sat-wik/HardFuzz/hardware/hardfuzz_v1/gen/_pcb_setup.txt

	(setup
		(stackup
			(layer "F.SilkS"
				(type "Top Silk Screen")
			)
			(layer "F.Paste"
				(type "Top Solder Paste")
			)
			(layer "F.Mask"
				(type "Top Solder Mask")
				(color "Green")
				(thickness 0.01)
			)
			(layer "F.Cu"
				(type "copper")
				(thickness 0.035)
			)
			(layer "dielectric 1"
				(type "core")
				(thickness 1.51)
				(material "FR4")
				(epsilon_r 4.5)
				(loss_tangent 0.02)
			)
			(layer "B.Cu"
				(type "copper")
				(thickness 0.035)
			)
			(layer "B.Mask"
				(type "Bottom Solder Mask")
				(color "Green")
				(thickness 0.01)
			)
			(layer "B.Paste"
				(type "Bottom Solder Paste")
			)
			(layer "B.SilkS"
				(type "Bottom Silk Screen")
			)
			(copper_finish "None")
			(dielectric_constraints no)
		)
		(pad_to_mask_clearance 0)
		(allow_soldermask_bridges_in_footprints no)
		(tenting front back)
		(aux_axis_origin 33.02 118.745)
		(grid_origin 33.02 118.745)
		(pcbplotparams
			(layerselection 0x00000000_00000000_00000000_000000a5)
			(plot_on_all_layers_selection 0x00000000_00000000_00000000_00000000)
			(disableapertmacros no)
			(usegerberextensions yes)
			(usegerberattributes no)
			(usegerberadvancedattributes no)
			(creategerberjobfile no)
			(dashed_line_dash_ratio 12.000000)
			(dashed_line_gap_ratio 3.000000)
			(svgprecision 6)
			(plotframeref no)
			(mode 1)
			(useauxorigin no)
			(hpglpennumber 1)
			(hpglpenspeed 20)
			(hpglpendiameter 15.000000)
			(pdf_front_fp_property_popups yes)
			(pdf_back_fp_property_popups yes)
			(pdf_metadata yes)
			(pdf_single_document no)
			(dxfpolygonmode yes)
			(dxfimperialunits yes)
			(dxfusepcbnewfont yes)
			(psnegative no)
			(psa4output no)
			(plot_black_and_white yes)
			(plotinvisibletext no)
			(sketchpadsonfab no)
			(plotpadnumbers no)
			(hidednponfab no)
			(sketchdnponfab yes)
			(crossoutdnponfab yes)
			(subtractmaskfromsilk no)
			(outputformat 1)
			(mirror no)
			(drillshape 1)
			(scaleselection 1)
			(outputdirectory "")
		)
	)
