sat-wik/HardFuzz/hardware/hardfuzz_v1/gen/kigen.py

#!/usr/bin/env python3
"""kigen — a tiny KiCad 10 schematic generator for the HardFuzz v1 board.

The board is defined as code (see sheets/*.py); this emits a valid `.kicad_sch`
(format 20250114) that opens in eeschema and passes ERC. Approach:

  * pull each library symbol's *raw text* from KiCad's stock .kicad_sym files so
    quoting/formatting is authoritative (no re-serialization guesswork),
  * place every component at rotation 0 so the pin transform is just Y-flip
    (sheet_pin = origin + (px, -py)),
  * connect pins with local net *labels* dropped exactly on each pin endpoint —
    same label name == same net, no fragile wire routing.

The result is an electrically-correct, ERC-checkable "netlist as schematic".
Aesthetic routing is left to eeschema; correctness is what we generate.
"""
import os, re, sys, uuid, math

SYMDIR = "/Applications/KiCad/KiCad.app/Contents/SharedSupport/symbols"
SKILL = "/Users/satwikpattanaik/.claude/plugins/marketplaces/kicad-happy/skills/kicad/scripts"
sys.path.insert(0, SKILL)
import sexp_parser as S


def _match_block(text, start):
    """Given index of '(' at `start`, return end index just past matching ')'."""
    depth = 0
    i = start
    in_str = False
    while i < len(text):
        c = text[i]
        if in_str:
            if c == '"' and text[i-1] != '\\':
                in_str = False
        elif c == '"':
            in_str = True
        elif c == '(':
            depth += 1
        elif c == ')':
            depth -= 1
            if depth == 0:
                return i + 1
        i += 1
    raise ValueError("unbalanced")


class LibCache:
    def __init__(self):
        self._files = {}   # libname -> text
        self._raw = {}     # lib_id -> renamed raw symbol block
        self._pins = {}    # lib_id -> [(number,x,y,angle)]

    def _load(self, libname):
        if libname not in self._files:
            with open(os.path.join(SYMDIR, libname + ".kicad_sym")) as f:
                self._files[libname] = f.read()
        return self._files[libname]

    def _find_symbol_span(self, text, name):
        pat = re.compile(r'\(symbol\s+"' + re.escape(name) + r'"')
        m = pat.search(text)
        if not m:
            raise KeyError(name)
        end = _match_block(text, m.start())
        return m.start(), end

    def _base_block(self, lib_id):
        """(raw text, base symbol name) of the ancestor that actually carries pins,
        following `extends` down the chain."""
        libname, name = lib_id.split(":")
        text = self._load(libname)
        s, e = self._find_symbol_span(text, name)
        block = text[s:e]
        m = re.search(r'\(extends\s+"([^"]+)"', block)
        if m:
            return self._base_block(f"{libname}:{m.group(1)}")
        return block, name

    def raw(self, lib_id):
        """Self-contained '(symbol "lib:name" ...)' block for lib_symbols embedding.
        Derived symbols are flattened onto the ancestor's drawing, and BOTH the top
        symbol and its child units are renamed so the child base matches the top's
        un-prefixed name (KiCad requires "<TopBase>_<unit>_<style>")."""
        if lib_id in self._raw:
            return self._raw[lib_id]
        block, base = self._base_block(lib_id)
        top_base = lib_id.split(":")[1]
        # child units: "<base>_u_s" -> "<top_base>_u_s"
        block = re.sub(r'(\(symbol\s+")' + re.escape(base) + r'(_)',
                       lambda mm: mm.group(1) + top_base + mm.group(2), block)
        # top-level: "<base>" -> "lib:name"
        block = re.sub(r'(\(symbol\s+")' + re.escape(base) + r'(")',
                       lambda mm: mm.group(1) + lib_id + mm.group(2), block, count=1)
        self._raw[lib_id] = block
        return block

    def _sym_node(self, libname, name):
        doc = S.parse_file(os.path.join(SYMDIR, libname + ".kicad_sym"))
        root = doc[0] if doc and isinstance(doc[0], list) else doc
        for n in root:
            if isinstance(n, list) and n and n[0] == "symbol" and len(n) > 1 and n[1] == name:
                return n
        raise KeyError(name)

    def extends(self, lib_id):
        """Parent lib_id if this symbol derives from another (via (extends ...)), else None.
        Reads the ORIGINAL library block — raw() flattens the extends token away."""
        libname, name = lib_id.split(":")
        text = self._load(libname)
        s, e = self._find_symbol_span(text, name)
        m = re.search(r'\(extends\s+"([^"]+)"', text[s:e])
        return f"{libname}:{m.group(1)}" if m else None

    def pins_by_unit(self, lib_id):
        """{unit_number: [(num,x,y,angle), ...]}. Child symbols are named
        '<base>_<unit>_<style>'; unit 0 holds common pins shared by every unit."""
        if lib_id in self._pins:
            return self._pins[lib_id]
        libname, name = lib_id.split(":")
        sym = self._sym_node(libname, name)
        per, total = {}, 0
        for u in sym:
            if isinstance(u, list) and u and u[0] == "symbol":
                m = re.match(re.escape(name) + r'_(\d+)_(\d+)$', u[1] if len(u) > 1 else "")
                unit = int(m.group(1)) if m else 1
                for k in u:
                    if isinstance(k, list) and k and k[0] == "pin":
                        at = S.find_first(k, "at"); num = S.find_first(k, "number")
                        if at and num:
                            per.setdefault(unit, []).append(
                                (num[1], float(at[1]), float(at[2]), float(at[3])))
                            total += 1
        if total == 0:                    # derived symbol: pins live on the parent
            parent = self.extends(lib_id)
            if parent:
                per = self.pins_by_unit(parent)
        self._pins[lib_id] = per
        return per

    def unit_count(self, lib_id):
        return max((u for u in self.pins_by_unit(lib_id) if u > 0), default=1)

    def pins(self, lib_id, unit=1):
        """Pins for a given unit, including any common (unit-0) pins."""
        pb = self.pins_by_unit(lib_id)
        return pb.get(0, []) + pb.get(unit, [])


def uid():
    return str(uuid.uuid4())


class Comp:
    def __init__(self, lib_id, ref, value, x, y, nets, footprint="", rot=0, unit=1,
                 stub=True, nc_unused=False, mpn=""):
        self.lib_id, self.ref, self.value = lib_id, ref, value
        self.x, self.y, self.rot = float(x), float(y), rot
        self.nets = nets            # {pin_number: net_name}
        self.footprint = footprint
        self.unit = unit
        self.stub = stub
        self.nc_unused = nc_unused  # place no-connect flags on pins with no net
        self.mpn = mpn
        self.uuid = uid()

    def pin_xy(self, px, py):
        # rotation 0 only: schematic Y is inverted vs symbol library
        return self.x + px, self.y - py


class Schematic:
    def __init__(self, title="HardFuzz v1", paper="A2"):
        self.lib = LibCache()
        self.comps = []
        self.title = title
        self.paper = paper
        self.uuid = uid()
        self.ox = 0.0          # block origin offset — set per block during assembly
        self.oy = 0.0
        # hierarchical assembly: when root_uuid is set this schematic is a sub-sheet
        self.root_uuid = None
        self.sheet_uuid = None     # uuid of the (sheet) symbol in the root that hosts us
        self.page = "1"
        self.global_nets = set()   # nets emitted as global_label (cross-sheet)

    @property
    def _sid(self):
        return self.sheet_uuid or self.uuid

    @property
    def _inst_path(self):
        return f"/{self.root_uuid}/{self._sid}" if self.root_uuid else f"/{self._sid}"

    @property
    def _sheet_path(self):
        return f"/{self._sid}" if self.root_uuid else "/"

    def origin(self, ox, oy):
        """Set the offset added to every subsequently-added component's position,
        so a block authored in local coords lands in its own board region."""
        self.ox, self.oy = float(ox), float(oy)

    GRID = 1.27

    def add(self, *a, **k):
        c = Comp(*a, **k)
        # snap the component origin to the 1.27 mm grid; pin offsets are already on
        # grid, so pin points / stub ends / labels derived from it stay on grid too
        c.x = round((c.x + self.ox) / self.GRID) * self.GRID
        c.y = round((c.y + self.oy) / self.GRID) * self.GRID
        self.comps.append(c)
        return c

    def _sym_instance(self, c):
        lines = []
        L = lines.append
        L(f'\t(symbol')
        L(f'\t\t(lib_id "{c.lib_id}")')
        L(f'\t\t(at {c.x:.2f} {c.y:.2f} {c.rot})')
        L(f'\t\t(unit {c.unit})')
        L(f'\t\t(exclude_from_sim no)')
        L(f'\t\t(in_bom yes)')
        L(f'\t\t(on_board yes)')
        L(f'\t\t(dnp no)')
        L(f'\t\t(uuid "{c.uuid}")')
        L(f'\t\t(property "Reference" "{c.ref}" (at {c.x+2.54:.2f} {c.y-1.27:.2f} 0)')
        L(f'\t\t\t(effects (font (size 1.27 1.27)) (justify left)))')
        L(f'\t\t(property "Value" "{c.value}" (at {c.x+2.54:.2f} {c.y+1.27:.2f} 0)')
        L(f'\t\t\t(effects (font (size 1.27 1.27)) (justify left)))')
        fp = c.footprint
        L(f'\t\t(property "Footprint" "{fp}" (at {c.x:.2f} {c.y:.2f} 0)')
        L(f'\t\t\t(effects (font (size 1.27 1.27)) (hide yes)))')
        if c.mpn:
            L(f'\t\t(property "MPN" "{c.mpn}" (at {c.x:.2f} {c.y:.2f} 0)')
            L(f'\t\t\t(effects (font (size 1.27 1.27)) (hide yes)))')
        # pin uuids
        for (num, px, py, ang) in self.lib.pins(c.lib_id, c.unit):
            L(f'\t\t(pin "{num}" (uuid "{uid()}"))')
        L(f'\t\t(instances')
        L(f'\t\t\t(project "hardfuzz_v1"')
        L(f'\t\t\t\t(path "{self._inst_path}" (reference "{c.ref}") (unit {c.unit}))))')
        L(f'\t)')
        return "\n".join(lines)

    STUB_MAX_PINS = 24    # above this, label on the pin directly — stubs on dense ICs
    #                       would cross neighbouring pins and short them together

    def _labels(self, c, stub=2.54):
        """For each connected pin: the net label at (or just off) the pin endpoint.
        Sparse parts get a short outward wire stub so labels sit clear of the body;
        dense ICs get the label right on the pin to avoid stub-crossing shorts. Text
        is justified so it always extends AWAY from the component body, never over it."""
        out = []
        pins = self.lib.pins(c.lib_id, c.unit)
        use_stub = c.stub and len(pins) <= self.STUB_MAX_PINS
        for (num, px, py, ang) in pins:
            net = c.nets.get(num)
            if not net:
                continue
            x, y = c.pin_xy(px, py)                 # pin connection point (sheet coords)
            a = math.radians((ang + 180) % 360)     # outward direction (pin `ang` -> body)
            dx, dy = math.cos(a), -math.sin(a)      # sheet space (Y flipped)
            if use_stub:
                ex, ey = round(x + dx * stub, 2), round(y + dy * stub, 2)
                out.append(
                    f'\t(wire (pts (xy {x:.2f} {y:.2f}) (xy {ex:.2f} {ey:.2f}))\n'
                    f'\t\t(stroke (width 0) (type default)) (uuid "{uid()}"))')
            else:
                ex, ey = x, y
            # rotate the label to run along the pin and justify text outward from the body
            if abs(dx) >= abs(dy):
                lang = 0
                just = "right" if dx < 0 else "left"
            else:
                lang = 90
                just = "right" if dy > 0 else "left"
            eff = f'(effects (font (size 1.27 1.27)) (justify {just}))'
            if net in self.global_nets:
                out.append(f'\t(global_label "{net}" (shape bidirectional) '
                           f'(at {ex:.2f} {ey:.2f} {lang})\n\t\t{eff}\n\t\t(uuid "{uid()}"))')
            else:
                out.append(f'\t(label "{net}" (at {ex:.2f} {ey:.2f} {lang})\n'
                           f'\t\t{eff}\n\t\t(uuid "{uid()}"))')
        return "\n".join(out)

    def _no_connects(self, c):
        """No-connect flags on this unit's pins that carry no net (intentional spares)."""
        out = []
        for (num, px, py, ang) in self.lib.pins(c.lib_id, c.unit):
            if c.nets.get(num):
                continue
            x, y = c.pin_xy(px, py)
            out.append(f'\t(no_connect (at {x:.2f} {y:.2f}) (uuid "{uid()}"))')
        return "\n".join(out)

    def render(self):
        used = {}                               # raw() flattens extends, so each
        for c in self.comps:                    # lib_id embeds as a self-contained symbol
            if c.lib_id not in used:
                used[c.lib_id] = self.lib.raw(c.lib_id)
        parts = []
        parts.append('(kicad_sch')
        parts.append('\t(version 20260306)')
        parts.append('\t(generator "hardfuzz-kigen")')
        parts.append('\t(generator_version "9.0")')
        parts.append(f'\t(uuid "{self.uuid}")')
        parts.append(f'\t(paper "{self.paper}")')
        parts.append('\t(title_block')
        parts.append(f'\t\t(title "{self.title}")')
        parts.append('\t)')
        parts.append('\t(lib_symbols')
        for lid, raw in used.items():
            # indent raw block by one tab
            parts.append("\n".join("\t" + ln for ln in raw.splitlines()))
        parts.append('\t)')
        for c in self.comps:
            parts.append(self._sym_instance(c))
            lbl = self._labels(c)
            if lbl:
                parts.append(lbl)
            if c.nc_unused:
                nc = self._no_connects(c)
                if nc:
                    parts.append(nc)
        parts.append(f'\t(sheet_instances\n\t\t(path "{self._sheet_path}" (page "{self.page}")))')
        parts.append('\t(embedded_fonts no)')
        parts.append(')')
        return "\n".join(parts) + "\n"

    PAPERS = [("A4", 297, 210), ("A3", 420, 297), ("A2", 594, 420),
              ("A1", 841, 594), ("A0", 1189, 841)]

    def _content_pts(self):
        """Every drawn point that must stay inside the frame: pin ends, stub-label
        anchors + their text extent, and component origins (Reference/Value text)."""
        pts = []
        for c in self.comps:
            pts.append((c.x + 3, c.y - 3))          # Reference/Value text sits above-right
            pins = self.lib.pins(c.lib_id, c.unit)
            use_stub = c.stub and len(pins) <= self.STUB_MAX_PINS
            for (num, px, py, ang) in pins:
                x, y = c.pin_xy(px, py)
                pts.append((x, y))
                net = c.nets.get(num)
                if not net:
                    continue
                if use_stub:
                    a = math.radians((ang + 180) % 360)
                    x, y = x + math.cos(a) * 2.54, y - math.sin(a) * 2.54
                gl = net in self.global_nets
                tw = len(net) * 0.95 + (7 if gl else 3)   # label text / flag reach
                pts.append((x + tw, y))                   # reserve room both sides — text
                pts.append((x - tw, y))                   # justifies away from the body
        return pts

    def autofit(self, margin=25, title_allow=35):
        """Translate content inside a margin and pick the smallest standard paper that
        contains all of it (pins + labels + text), so nothing spills past the frame."""
        pts = self._content_pts()
        if not pts:
            return
        minx = min(p[0] for p in pts); maxx = max(p[0] for p in pts)
        miny = min(p[1] for p in pts); maxy = max(p[1] for p in pts)
        dx, dy = margin - minx, margin - miny
        for c in self.comps:
            c.x += dx; c.y += dy
        w = (maxx - minx) + 2 * margin
        h = (maxy - miny) + 2 * margin + title_allow
        for name, pw, ph in self.PAPERS:
            if w <= pw and h <= ph:
                self.paper = name
                return
        self.paper = "A0"

    def check(self):
        """Detect accidental shorts: two different nets whose pins/stub-wires land on
        the same grid point. Stub segments are sampled at 1.27 mm so overlapping
        collinear stubs are caught. Returns [((x,y), {nets}), ...]."""
        occ = {}
        def mark(pt, net):
            occ.setdefault(pt, set()).add(net)
        for c in self.comps:
            pins = self.lib.pins(c.lib_id, c.unit)
            use_stub = c.stub and len(pins) <= self.STUB_MAX_PINS
            for (num, px, py, ang) in pins:
                net = c.nets.get(num)
                if not net:
                    continue
                x, y = c.pin_xy(px, py)
                mark((round(x, 2), round(y, 2)), net)
                if use_stub:
                    out_ang = math.radians((ang + 180) % 360)
                    dx, dy = math.cos(out_ang), -math.sin(out_ang)
                    steps = int(round(2.54 / 1.27))
                    for i in range(1, steps + 1):
                        d = 1.27 * i
                        mark((round(x + dx * d, 2), round(y + dy * d, 2)), net)
        return [(p, nets) for p, nets in occ.items() if len(nets) > 1]

    def write(self, path):
        conflicts = self.check()
        if conflicts:
            msg = "; ".join(f"{p}:{sorted(n)}" for p, n in conflicts[:8])
            print(f"  !! {len(conflicts)} net collision(s): {msg}")
        with open(path, "w") as f:
            f.write(self.render())
        return conflicts
