sat-wik/HardFuzz/(commit log)

2026-07-21 Scaffolding: toolchain, constraints, docs, UART bring-up + timing primitive
2026-07-21 Month 1: host-armed SPI bit-flip injection (spi_slave + bitflip_inj + ctrl_regs)
    [bitflip_inj.v, ctrl_regs.v, spi_inject_top.v, spi_slave.v, tb_ctrl_regs.v, tb_spi_inject.v]
2026-07-21 Month 2: host-armed I2C clock-stretch injection (i2c_slave + timing_distort)
2026-07-21 Month 2: CAN frame corruption via force-dominant (sim-only)
2026-07-21 Firmware: STM32F446 SPI + I2C masters with UART run-command
2026-07-21 Host: C++ campaign/coverage/report layer + hardfuzz CLI + arm.py
2026-07-21 README: landing-page intro, capability matrix, fix dead product-plan link
2026-07-21 Add SPI bit-flip sweep campaign + generator
2026-07-21 Month 4: combined SPI+I2C multi_inject_top (reg4 protocol select)
    One bitstream drives both injectors; only the selected protocol touches its bus, so both can stay wired. Host arm.py/RegClient write reg4. Verified in sim (tb_multi_inject) + host suite.
2026-07-21 Month 4: combined SPI+I2C STM32 firmware (main_multi.c) + protocol-aware DutRunner
    main_multi selects protocol via 'S'/'I' and runs on 'R'. The host DutRunner now sends {proto,'R'}; standalone firmwares ignore the proto byte, so all three stay compatible. Enables mixed-protocol live campaigns against multi_inject_top with zero reflashing.
2026-07-21 Add mixed SPI+I2C campaign for multi_inject_top validation
2026-07-21 docs: HardFuzz v1 product spec (board I/O, attach modes, out-of-box experience)
2026-07-21 hardware: HardFuzz v1 PCB design package (schematic spec + BOM)
    Net-level schematic design reusing the proven Cmod A7 core (Artix-7 CPG236 +
    FT2232H + QSPI) plus productization: TXS0108E level-shifted bus I/O with VREF
    sensing, onboard SN65HVD230 CAN transceiver, and keyed target connectors. BOM
    lands ~$40/unit at 100 qty. KiCad capture is the mechanical next step.
    [bom.csv]
2026-07-21 hardware: resolve v1 schematic open decisions
    FTG256 package (1.0mm fan-out over CPG236's 0.5mm); TXS0108E VCCA<=VCCB rule
    scopes v1 to 3.3-5V targets (1.8V deferred to a rev needing a 1.8V bus bank);
    DNP 74LVC1T45 pads for high-speed SPI; both IN/OUT to FPGA for inline; jumper
    CAN termination default-off. BOM + product-spec voltage claim updated to match.
    [bom.csv]
2026-07-21 hardware: KiCad parts-readiness checklist (stock vs. grab/draw)
2026-07-21 hardware: KiCad capture as code (kigen) + netlist-verified power sheet
    kigen.py generates KiCad 10 (.kicad_sch, format 20260306) schematics from a
    code description: pulls authoritative symbols from KiCad's stock .kicad_sym,
    flattens extends/derived symbols, and wires nets via labels on pin endpoints.
    power_sheet.py emits the v1 power tree (3 regulators, rails, feedback dividers)
    which loads in eeschema, renders, and passes netlist connectivity checks via
    kicad-cli. Remaining sheets + FPGA symbol import are next.
    [power.kicad_sch]
2026-07-21 hardware(kigen): wire stubs + labels off pins; space out power sheet
    Each pin now gets a short outward wire stub with the net label at its end, so
    labels sit clear of symbol bodies. Power blocks spread ~100mm apart. Netlist
    connectivity verified unchanged. Much more readable in eeschema.
    [power.kicad_sch]
2026-07-21 hardware(kigen): CAN sheet — SN65HVD230 + split termination + screw terminal
    Transceiver logic side to CAN_TXD/RXD, bus side through split-120R termination
    to a 3-pos screw terminal, Rs slope resistor, VCC decoupling; Vref correctly
    open. Netlist-verified via kicad-cli.
    [can.kicad_sch]
2026-07-21 hardware(kigen): complete schematic capture — all 5 blocks + assembled board
    Adds level-shifter, USB/FT2232H+flash, and FPGA (XC7A35T-CSG324, 5-unit)
    sheets, plus build_board.py assembling all blocks into one connected
    board.kicad_sch (67 parts, 300 nets). kigen gains multi-unit symbols,
    extends-flattening, grid snapping, and a build-time short detector.
    Cross-block connectivity verified via kicad-cli netlist (SPI/JTAG/flash/CAN/
    VREF span blocks). Reviewed with the kicad-happy skill: all subsystems detected
    at HIGH trust; VBUS TVS added per its UC-002 finding. FPGA switched CSG324 (stock
    KiCad symbol, no import) — docs/BOM/parts updated.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
    [board.kicad_sch, bom.csv, can.kicad_sch, power.kicad_sch]
2026-07-21 hardware(kigen): hierarchical schematic — one readable page per subsystem
    Reorganise the flat board into a hierarchical KiCad project: root board.kicad_sch
    instantiates five sub-sheets (FPGA/Power/CAN/Level-Shift/USB), each its own legible
    page. kigen gains global-label + hierarchical-instance-path support; build_board
    auto-detects cross-sheet nets (24) and emits them as global labels, keeping block-
    internal nets local. Verified: root loads and renders 6 pages, cross-sheet netlist
    connects (SPI/JTAG/flash/CAN/VREF span sheets), 0 collisions, and the kicad-happy
    skill parses all 6 sheets at HIGH trust.
    [board.kicad_sch, can.kicad_sch, fpga.kicad_sch, levelshift.kicad_sch, power.kicad_sch, usb.kicad_sch]
2026-07-21 hardware(kigen): review cleanup — NC flags, MPNs, PG/flag fixes, FPGA on A1
    Address kicad-happy skill + ERC findings on the hierarchical board:
    - no-connect flags on all intentional spare pins (unconnected 238 -> 0)
    - MPNs on 16 ICs/connectors; grid-snapped endpoints
    - fix buck PG mis-map (was tied to VIN) and drop double-driver PWR_FLAGs
    - rename FT core rail VDDCORE_FT so PP-001 reads it as an internal rail (info)
    - FPGA sub-sheet on A1 so all 5 units fit on the page
    kigen gains no_connect + MPN emission. Skill review now: 1 error (SS-001
    sourcing gate, needs passive MPNs) + benign info; netlist connectivity intact.
    [board.kicad_sch, can.kicad_sch, fpga.kicad_sch, levelshift.kicad_sch, power.kicad_sch, usb.kicad_sch]
2026-07-21 hardware(kigen): readability — auto-fit paper/margins + labels justified outward
    Two fixes so every sheet reads cleanly:
    - autofit(): translate each sheet's content inside a margin and pick the smallest
    standard paper that contains it (pins + labels + text) — nothing spills past the
    frame anymore (level-shift/USB previously exceeded A3).
    - direction-aware label justification: net labels now extend AWAY from the
    component body (left-side pins' text goes left, right-side right, connector
    columns split) instead of overprinting the symbol.
    Netlist connectivity + 0 collisions verified unchanged.
    [board.kicad_sch, can.kicad_sch, fpga.kicad_sch, levelshift.kicad_sch, power.kicad_sch, usb.kicad_sch]
2026-07-22 hardware: generate placed PCB (hardfuzz_v1.kicad_pcb) + footprints; rename root
    kigen_pcb.py generates the PCB from the schematic netlist: loads each part's
    stock .kicad_mod, shelf-packs footprints (origin-offset so courtyards don't
    overlap), injects pad nets, and adds a board outline + 2-layer stackup. Loads in
    pcbnew with 68 footprints and 302 nets on the right pads; the 317 'unconnected'
    are the unrouted nets (routing is interactive/autorouter — the generator sets it
    up, doesn't draw copper).
    Also: assigned real footprints to the 6 ICs that lacked them and fixed 2 wrong
    names (all now resolve, incl BGA-324 + QFN-64). Renamed the root schematic/PCB to
    hardfuzz_v1.* so the project opens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
    [can.kicad_sch, fpga.kicad_sch, hardfuzz_v1.kicad_pcb, hardfuzz_v1.kicad_sch, levelshift.kicad_sch, power.kicad_sch, usb.kicad_sch]
2026-07-22 v2: standalone/BLE architecture doc + ESP32 controller added to the board
    docs/HardFuzz_v2_Standalone.md: computer-free architecture — an on-board ESP32-S3
    runs the header-only C++ campaign engine (ports nearly as-is), arms the FPGA over
    UART, drives the DUT, and streams results to a phone app over BLE. Includes the GATT
    service definition and the host-engine -> ESP32 mapping.
    Design: gen/esp32_sheet.py adds the ESP32-S3-WROOM-1 (power, EN/IO0 boot circuits,
    UART to FPGA via the freed FT2232 ch-B control nets, UART to a DUT header, USB-C for
    programming, BLE LED). Regenerated schematic (7 sheets, 83 parts) + PCB (loads,
    ESP32 placed). FT2232 keeps JTAG; ESP32 owns the runtime control path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
    [can.kicad_sch, esp32.kicad_sch, fpga.kicad_sch, hardfuzz_v1.kicad_pcb, hardfuzz_v1.kicad_sch, levelshift.kicad_sch, power.kicad_sch, usb.kicad_sch]
2026-07-22 firmware(esp32): scaffold the v2 standalone controller (reuses the host engine)
    firmware/esp32/ — ESP-IDF project for the ESP32-S3 that runs the campaign engine
    standalone and streams results over BLE. Structure:
    - esp_uart_transport.hpp: the ONE glue class (hardfuzz::Transport over ESP-IDF UART);
    used for both the FPGA ctrl_regs (RegClient) and the DUT (existing SerialDutRunner)
    - main.cpp: wires the reused engine; live coverage-guided campaign loop streaming
    each result — same arm/run/evaluate/mark as CampaignRunner
    - ble_service.hpp/.cpp: GATT service (Info/Campaign/Control/Status/Result); engine
    dispatch is real, NimBLE host bring-up is scaffold pending on-hardware test
    - hf_co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
2026-07-22 app: scaffold the v2 phone app (BLE client + decoders + report generator)
    app/ — Flutter BLE client for the standalone HardFuzz. Core scaffolded and
    contract-verified against the firmware:
    - models.dart: Status/Result notification decoders, byte-matched to ble_service.cpp
    (round-trip cross-checked: firmware encode <-> app decode agree)
    - hardfuzz_ble.dart: scan/connect (247 MTU), subscribe to Status+Result, push
    campaign (chunked JSON + 0x00 terminator), Control start/stop/manual-arm
    - report.dart: IEC 61508/ISO 26262 HTML evidence report (mirrors host report.hpp),
    PDF via printing
    - GATT UUIDs computed from the firmware's macro so both ends match exactly
    TODO: the Flutter UI (conne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
2026-07-22 app: build the Flutter UI (connect / campaign / run / report screens)
    Four screens wired to the BLE client + streams:
    - connect: scan (filtered on the HardFuzz service), tap to connect, read Device Info
    - campaign: pick a preset (mirrors host/campaigns), Push & Run (chunked push + START)
    - run: live LinearProgressIndicator from Status, streaming pass/fail results list
    - report: KPIs + traceability DataTable, Export PDF via printing (buildHtmlReport)
    main.dart + store.dart (shared state + presets). Report joins results with the
    campaign for requirement/expect traceability. Platform folders (android/ios) are
    generated locally with 'flutter create .'; BLE permissions added there.
    Co-Authored-B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
2026-07-22 docs: v2 build & bring-up checklist (repo -> working standalone unit)
    Ordered phases with commands, files, and 'done when' signals: finish the PCB
    (4-layer stackup, net classes, BGA fanout, route, fab), assemble, power bring-up,
    FPGA bitstream (new CSG324 .xdc), ESP32 firmware (build/flash/NimBLE), app
    (flutter create/permissions/run), system integration, validation. Includes a risk
    map of where the real work is (BGA routing, CSG324 pinout, NimBLE, antenna keepout).
2026-07-22 hardware(pcb): steps 1-4 via pcbnew API — 4-layer, grouped placement, outline, planes
    gen/pcb_layout.py drives KiCad's pcbnew API (valid by construction) to do the PCB
    bring-up prep: 4-layer stackup, placement grouped by subsystem (from netlist
    sheetpaths, decoupling caps clustered with their ICs), board outline sized to fit,
    and GND(In1)/+3V3(In2) planes. Runs in two processes (LoadBoard works once per
    process; zone-ops after SetCopperLayerCount segfault in-session) and needs a wxApp
    for headless zone ops. Board is now 174x173mm, 4 layers, 2 planes.
    Left for the GUI: press B to pour zones, add 4 mounting holes, net-class/rule setup,
    and routing (step 5).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
    [hardfuzz_v1.kicad_pcb]
2026-07-22 hardware(pcb): finish steps 1-4 — pour planes, mounting holes, net classes + rules
    pcb_layout.py now chains four passes (each its own process): grouped placement +
    4-layer + outline, then planes, then pour, then mounting holes. Poured GND/+3V3
    planes drop unconnected 363->332. Added the Power net class (+*/GND patterns,
    0.4mm tracks / 0.8mm vias) and relaxed rules (0.45/0.25 vias, 0.15 tracks) to the
    project file for the BGA fanout. Board is fully bring-up-ready except routing.
    [hardfuzz_v1.kicad_pcb]
